Vital-link/Vital-link-hardware/generalDesign_documentation/GenericNodeDesignDecisionDocumentation.docx

# XIAO NRF52840 board or CUSTOM BOARD

| Pros
Xiao | - More reliable as it already works - Very small PCB(hard to beat) - cheaper
Custom pcb | - More learning - Slightly more customizable

Verdict:

By default, we will be using the XIAO board, unless there is a reason that the board needs to be more customizable

In terms of learning, I will be working on my own project which includes a lot of the xiao board anyways on the side to build the skills that I want.

# How is the Generic NODE board going to be connected to the sensor board?

We will have a battery sandwich

Node

Battery – 20mm x 12mm x 5mm

Custom SensorPCB

Link for 5.08 mm female headers. Gives 0.8mm offset. This seems to be the standard which seems to fit perfectly. Hopefully.

https://www.digikey.ca/en/products/filter/rectangular-connectors/headers-receptacles-female-sockets/315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

5.08mm male headers

https://www.digikey.ca/en/products/filter/headers-male-pins/314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

The MALE/FEMALE headers for PPG need to be a bit bigger, to allow component placement.

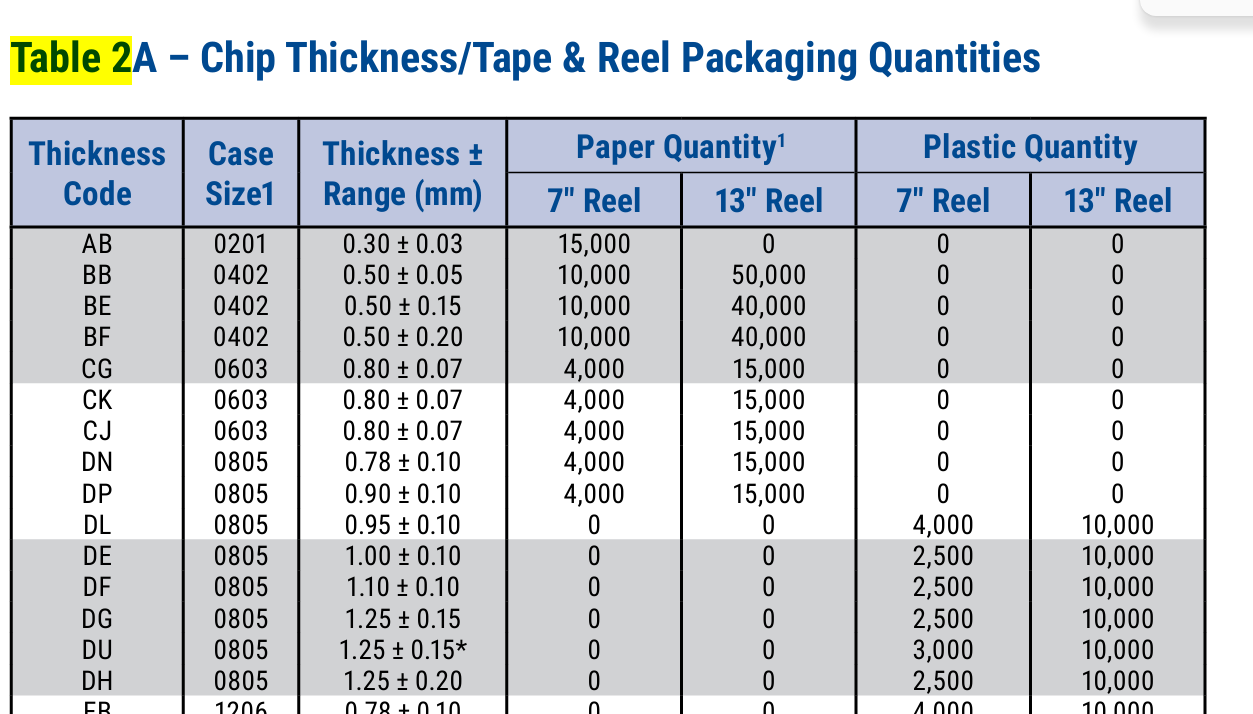
[picture p1: figure]

Figure 1 0805 resistor height

According to the 0805-component sheet. We should allow offset of 1.5mm atleast. We will choose 7mm height headers.

Female - 0.100" (2.54mm) Headers, Receptacles, Female Sockets | Rectangular Connectors | Electronic Components Distributor DigiKey (https://www.digikey.ca/en/products/filter/rectangular-connectors/headers-receptacles-female-sockets/315)

Male - 0.100" (2.54mm) Headers, Male Pins | Rectangular Connectors | Electronic Components Distributor DigiKey (https://www.digikey.ca/en/products/filter/headers-male-pins/314)

Header connections should be GOLD to maximize conductivity.

https://www.seeedstudio.com/Seeed-Studio-XIAO-24Ghz-mmwave-Human-Static-Presence-Module-p-6266.html

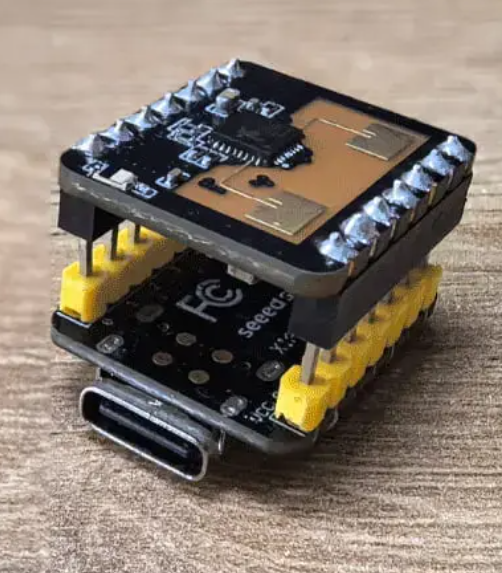
[picture p2: figure]

s
