Vital-link/Vital-link-hardware/generalDesign_documentation/memoryDesign.docx

# MEMORY DESIGNS

# Problem: There is not enough memory to be stored

SD card is chosen because it is the simplest to program and is a universal interface for memory. So, there’s a lot of resources on it.

# Drawbacks:

Significant current surge (100mA) what’s the current usage?

Increases size of product.
