Vital-link/Vital-link-hardware/generalDesign_documentation/EMG RESEARCH.docx

# EMG RESEARCH

## What is EMG signal?

EMG measures the sum of the electrical activity of multiple motor units; these are the motor unit action potentials (MUAPs).[6] This is observed as a bipolar signal with a symmetric distribution of positive and negative amplitudes (mean value equals zero).[7] Raw EMG spikes are of random shape.[7] The observed signal is influenced by the recruitment of the motor units and their firing frequency, as shown in Figure 2.7

The amplitude range of an EMG signal is 0-10 mV (-5 to +5) before amplification.[3] The amplitude has the potential to provide a measure of the magnitude of muscle force, but this relationship is complicated by both the character of the measured EMG and the muscle mechanics.[8] Typically, the frequency of an EMG signal ranges between 6 and 500 Hz, showing the most frequency power between 20 and 250 Hz.[7] An EMG signal is influenced by the firing rate of the motor units, which, in most conditions, fire in the frequency region of 0 to 20 Hz.[3]

# How to pick EMG amplifier?

The function of an amplifier is to take a weak electric signal of the body and increase its amplitude so that it is compatible with recording and displaying devices. A high-quality EMG amplifier has the following characteristics:

- A high input impedance, so as not to distort the signal coming in [6].
- A bandwidth in the frequency band of EMG: between 6 and 500 Hz [1].
- No hardware filters, so the signal information is not altered [1].
- A high common-mode rejection ratio (CMRR). This suppresses all signals ‘common’ to all recorded electrodes. One such example is 50 or 60 Hz powerline noise. Typically, the common mode voltage is much larger than the EMG signal, so a high CMRR is needed to distinguish the EMG signals [1].

# Picked EMG sensor

AD8422 for EMG applications because it has a very high range of changeable gain values. Highest CMRR values that I can find.

AD8236 – HIGH CMRR, input bias current: cutoff at 500Hz

MAX4208 – recommended

Something to consider is that we have high impedance dry electrodes.

And if you are using high impedance electrodes/dry electrodes you need small INPUT BIAS currents (DC current that flows into or out of an amplifier’s input pins so the internal transistors can operate.)

# Dry vs wet electrodes

impedance in the range of 10kΩ. However, when used with an ECG with dry electrodes, the impedance of the dry electrodes is 100 to 1000 times higher than conventional electrodes (for example, 10MΩ for dry electrodes vs. 10kΩ for conventional electrodes).

# Sources

What is the EMG signal - https://www.tmsi.artinis.com/blog/what-is-emghttps://www.tmsi.artinis.com/blog/what-is-emg

Picking AMPLIFIER - https://www.tmsi.artinis.com/blog/recommendations-to-acquire-good-emg-signals

Mains interference - https://www.tmsi.artinis.com/blog/mains-interference

Dry electrodes - https://www.analog.com/en/resources/design-notes/highimpedance-and-lownoise-op-amps-enable-dry-electrodes-in-medical-systems.html
