Vital-link/Vital-link-hardware/meetings/VL_HARDWARE_OVERVIEW_WEEK 3.docx

As of right now my focus will be to focus on ensuring the 3 + 1 sensors work, and concept of a multi-sensor network can be displayed during capstone day. With the sensors being accurate and small.

# TEMPERATURE

# PPG

# ECG

I was thinking about using wet electrode wires with 2mm connectors. However, after doing some more research, I realized how hard it is to get the components. It is more reliable to just build a PCB with 2-3 snap connectors on it with wet electrodes that can be attached onto the body right away.

Backup plan, 3.5mm connectors. With very long wires. You can stick the ECG node into your pocket

# EMG (bonus)

This sensor does not really add much to the narrative of the project. It will be a bonus sensor that is a bit risky but can showcase our technical capability.

I will be using dry electrodes (metal plates) to measure the EMG signals.

# IMU (bonus)

If firmware programmers want more sensors. There is an IMU sensor located within the sense XIAO board that can track step count, etc. This is a useful sensor we could add to our system

# Node

There is discussion about putting an MCU onboard a PCB. For the time being that is not within my plan as it

- provides little value to the project for an extremely high risk (nothing working).
- Takes time away from focusing on parts of project that are critical

One thing we could do that is risk free is once we finish all firmware/hardware is to take the open-sourced PCB and optimize it for our use cases as well as colour coating it + put logo on it.

There is some concern about the battery sandwich design. I should go talk to someone to ensure this is fine for signal integrity. (most likely is fine)

# Battery component choice

Initially I was thinking about using 50mAH which was the perfect size for our node. However, after looking at the shipping time (3 months)

The most reliable design for the node is to increasing battery capacity to 80mAH then adjusting the mechanical design. As 80mAH takes around 1 month to ship (which is much better)

# FLASH MEMORY

After realizing this week that our MCU will not have enough memory to hold raw data for an entire day. Our agreed upon solution is to put additional flash memory onto the sensor/node.

- Users want to be able to not have to carry hub around
- I like this idea as it has opportunity for high-speed digital design. However, is low risk if it doesn’t work as intended

# Potential things to do next week

- Research EMG chips in more detail
- Research affect of battery sandwich battery (return paths, different grounds)
- Begin schematics for ECG/EMG
- Begin flash memory component selection as well as researching a bit on high-speed digital design
