Vital-link/Vital-link-hardware/meetings/VL_HARDWARE_OVERVIEW_WEEK 2.docx

# WEEK 2: OVERVIEW HARDWARE

# What has been done?

## Temperature

- First breakout board ordered

## PPG

- First breakout board ordered

## ECG

- First breakout board has been chosen
- Multiple design options are being evaluated
- Wet electrodes have been chosen, this allows PCB to stick on chest with minimal wires, as well as accuracy to maximize chances of accurate respiratory readings

## EMG

- Picked amplifier with low cmrr and low input bias current making it suitable for EMG usage.
- Determined qualities of an EMG signal such as bandwidth, and amplitude of signals
- Conflict exists between designing an EMG system for unpredictable, low-signal electrode placement and a fixed, repeatable placement optimized for a game-based demo, since each demands different signal-quality assumptions.

# Questions:

## Temperature

Question: Where should these probes ideally be placed to best measure temperature?

Question: How to mount on person to look as nice as possible?

## Questions

## PPG

Question: Do you know how PPT blood pressure works? Explain. Further needs more work

## ECG

Question: Is electrode placement good? Length and positioning.

## EMG

- Using dry electrodes introduces additional noise and stability challenges, requiring more advanced noise-reduction techniques. Which is good for portfolio
- Designing with wet electrodes carries potential real-world
- Decision as of now

As of right now, the decision will be for dry electrodes.
