Vital-link/Vital-link-hardware/generalDesign_documentation/LIPOvsCOINCELL_documentation.docx

# Battery design choice

# Goals (What we want)

- Rechargeable

# Constraints (what MUST OCCUR)

- Over 24 hours of battery life
- Must be comfortable enough to wear for 24 hours
- The enclosure must have an appearance suitable for daily wear.
- Must be light weight enough to be held by electrode pads

# Options Considered

## Battery choice

### Coin Cell (CR2032)

- Easy to design minimal form factor around.
- Highest level of battery capacity
- Low levels of maximum current draw

### Li-Po Pouch Cell

- Rechargeable

So, for the Battery choice, we need to determine if the LIPO can

1. Be designed easily mechanically. Can it fit into the enclosure in a nice way
2. Does it have enough battery life to sustain 24 hours

# 3. Key Trade-offs

A primary trade-off in battery selection is between rechargeability and peak current capability versus simplicity and form factor.

Although the CR2032 coin cell has a higher nominal capacity (~225 mAh) compared to a 100 mAh Li-Po cell, its usable capacity is significantly reduced under pulsed, multi-milliamp loads due to high internal resistance and voltage sag. In practice, only approximately 30–70% of the rated capacity is accessible in BLE-based wearable applications.

In contrast, a 100 mAh Li-Po cell typically provides 85–95% of its rated capacity due to low internal resistance and stable voltage delivery, making its effective usable energy comparable to that of a CR2032 under realistic operating conditions.

The Li-Po solution supports higher peak currents required by BLE radio transmissions and PPG LED pulses but introduces additional charging and safety circuitry, increasing system complexity. The CR2032 offers a simpler and smaller solution but is less suitable for continuous sensing and higher duty-cycle operation.

# 4. Final Decision

Overall, the Li-Po battery is selected due to its ability to reliably supply higher peak currents, which are required for BLE communication and optical sensing, and because the effective usable capacity of a CR2032 coin cell is not significantly greater under realistic operating conditions. A dedicated mechanical structure will be designed around the Li-Po battery to ensure safe integration and protection within the device.

# 5. Risks & Mitigations

With the introduction of a Li-Po battery, there is an inherent risk of thermal runaway if the battery is overcharged. To mitigate this risk, multiple layers of protection will be implemented. These include hardware-level protection through a dedicated charging circuit with overvoltage protection, firmware-level protection by monitoring battery voltage and disabling charging under fault conditions, and mechanical protection by enclosing the battery within a protective chassis to reduce the risk of physical damage
