Vital-link/Vital-link-hardware/generalDesign_documentation/MCU SELECTION.docx

# MCU SELECTION

# ESP32

- Easy to use
- We don’t need WIFI capability
- Extremely energy intensive

# PICO2W

- Easy to use
- Has proprietary antenna. No RF pin. So, it is hard to develop hardware around that as well as is probably does not have good RF capabilities relative to boards that have dedicated pins for RF.

# STM32WB

- We have already developed experience using STM32IDE
- Lack of developed BLE ecosystem

# NRF52840

- Hard skill floor
- NORDIC brands selling point is literally low powered BLE devices. Best for wearables in the industry
- Highly established ecosystem for BLE meaning highest level of control over BLE protocol
- (I intuitively went for this board over STM32)
