Vital-link/Vital-link-hardware/VitalLink_ECG_Breakout_R1/Documentation/ECG_DESIGN.docx

## Why did I choose wet electrodes for ECG?

1. Wet electrodes stick onto the body making node look nicer.
2. On demo day, nobody wants to stick something on their heart that has touched 100 people’s hearts. So, it would just be a visual demo
3. Cleaner signal, reducing concern about extraction of respiration rate.

Something like this would be nice

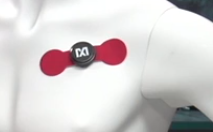
[picture p4: figure]

this is the goal for ECG. WET ELECTRODES. IDC

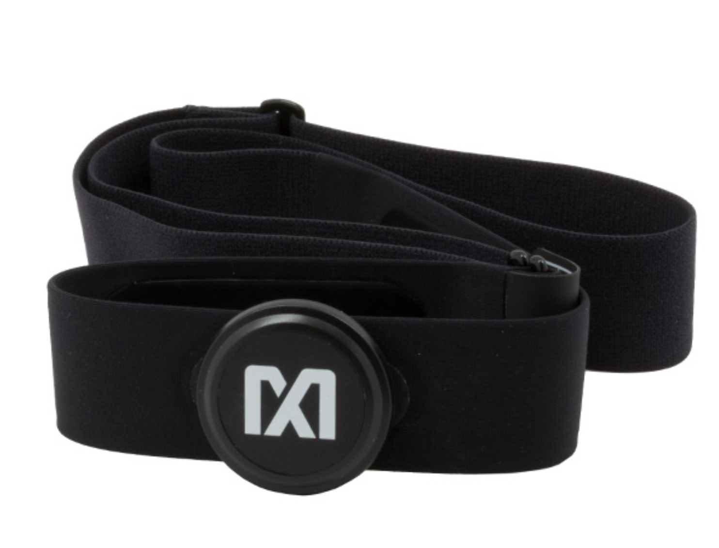
[picture p5: figure]

## Decision:

May be a good idea to talk with Anthony about the ECG/EMG design. Where must the placement of the electrodes be. How far apart must they be.

# Component selection options

MAX30003 – PROVIDES only Heartrate. Simpler but less parameters

MAX30001 – provides heart-rate, bio-impedance, and respiration.

MAX30001 is picked because I’m interested in respiration. It is riskier, but I have a big interest in determining breathe-rate.

MAX30003 can be ordered simultaneously

https://ez.analog.com/temperature_sensors/w/documents/21199/are-there-instructions-to-connect-the-ecg-leads-for-the-max30003-or-max30001

Here it says

Yes, see below. The MAX30001 and MAX30003 use two-lead measurements, with a third lead for body bias (similar to 'right leg drive'). The third lead is optional for battery-powered applications, but should be used if the customer's board is connected to a USB port or power supply.
