Vital-link/Vital-link-hardware/VitalLink_ECG_Breakout_R1/Documentation/ECG-SNAP-UNCERTAINTY.docx

# Problem:

SNAP ECG does not have a clearly defined method of installation on PCB. It has been done, and I am 100% certain it can be done. How it is done, is uncertain

# RESEARCH

## TWO METHODS HAVE BEEN EXPLORED

1. ECG CLAW

Designed specifically for PCB’s however the footprint is harder to make.

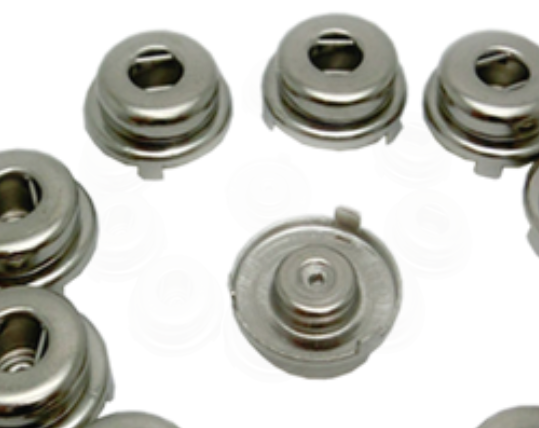
[picture p6: figure]

2. BUMP SNAP ELECTRODES

Easier to make, and μ emg has done it that way. Due to the slanted sides, I’m not certain I want to go with this

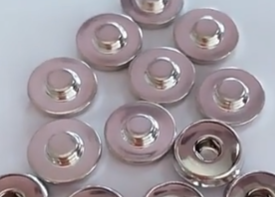
[picture p7: figure]

3. SHORT COLUMN ECG

This one is made for PCB’s but once again there’s a slant

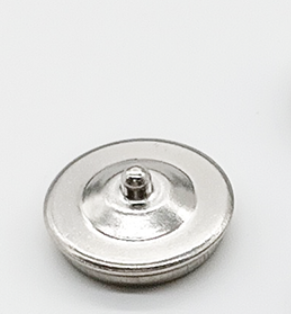
[picture p8: figure]

# Potential implementation

How does a rivot work

So it requires a small hole. Which as of now I have not found

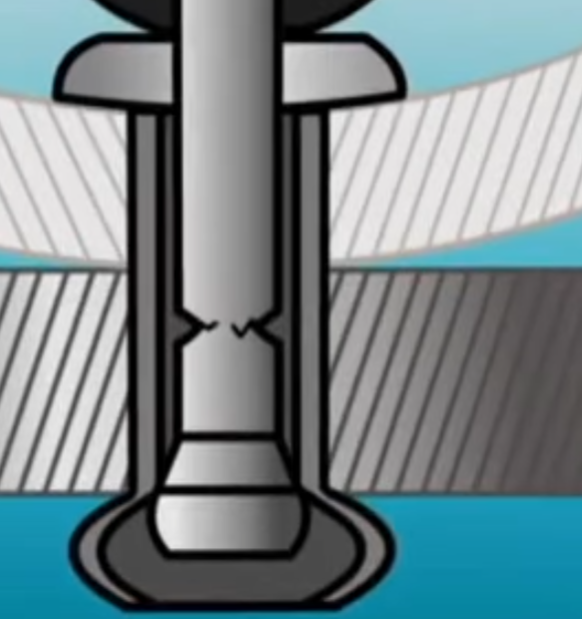
[picture p9: figure]

# Resources

https://www.alibaba.com/product-detail/Nickel-Plating-4-0mm-ECG-Female_1601408208499.html - best documentation with sizes

https://www.alibaba.com/product-detail/4_0mm_Short_Column_ECG_Female_Buckle_with_PCB_Easy_Welding_Terminal_Physiotherapy_Medical_Electronic_Buckle_1601408263267.html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 – this one is “PCB easy”
