Vital-link/Vital-link-hardware/generalDesign_documentation/dataRateCalculations.xlsx

 | EMG | ECG(programmable)
Sampling rate(Hz) | 1100 | 512
Data per sample( bits) | 32 | 32
Data per sample( bytes) | 4 | 4
Datarate (bytes/sec) | 4400 | 2048
Desired use time(H) | 24 | 25
Desired use time(s) | 86400 | 90000
Total data required( MB) | 380.16 | 184.32
