Vital-link/Vital-link-hardware/generalDesign_documentation/powerCalculations.xlsx

V_bat Max(V) | 4.2
V_bat Min(V) | 3.7
LDO V_BAT->3V3 (300mA MAX)
Vdo( Dropout Voltage) | 0.3
