Vital-link/Vital-link-hardware/generalDesign_documentation/Gantt Chart (Excel Template).xlsx

Vital link | Project Start Date | 2025-11-17 |  |  |  | Display Week
 |  |  |  |  |  |  | Week 1 |  |  |  |  |  |  | Week 2 |  |  |  |  |  |  | Week 3 |  |  |  |  |  |  | Week 4 |  |  |  |  |  |  | Week 5 |  |  |  |  |  |  | Week 6 |  |  |  |  |  |  | Week 7 |  |  |  |  |  |  | Week 8
 |  |  |  |  |  |  | 2025-11-17 |  |  |  |  |  |  | 2025-11-24 |  |  |  |  |  |  | 2025-12-01 |  |  |  |  |  |  | 2025-12-08 |  |  |  |  |  |  | 2025-12-15 |  |  |  |  |  |  | 2025-12-22 |  |  |  |  |  |  | 2025-12-29 |  |  |  |  |  |  | 2026-01-05
 |  |  |  |  |  |  | 2025-11-17 | 2025-11-18 | 2025-11-19 | 2025-11-20 | 2025-11-21 | 2025-11-22 | 2025-11-23 | 2025-11-24 | 2025-11-25 | 2025-11-26 | 2025-11-27 | 2025-11-28 | 2025-11-29 | 2025-11-30 | 2025-12-01 | 2025-12-02 | 2025-12-03 | 2025-12-04 | 2025-12-05 | 2025-12-06 | 2025-12-07 | 2025-12-08 | 2025-12-09 | 2025-12-10 | 2025-12-11 | 2025-12-12 | 2025-12-13 | 2025-12-14 | 2025-12-15 | 2025-12-16 | 2025-12-17 | 2025-12-18 | 2025-12-19 | 2025-12-20 | 2025-12-21 | 2025-12-22 | 2025-12-23 | 2025-12-24 | 2025-12-25 | 2025-12-26 | 2025-12-27 | 2025-12-28 | 2025-12-29 | 2025-12-30 | 2025-12-31 | 2026-01-01 | 2026-01-02 | 2026-01-03 | 2026-01-04 | 2026-01-05
WBS | TASK | LEAD | PREDECESSOR | START | END | DAYS | M | T | W | T | F | S | S | M | T | W | T | F | S | S | M | T | W | T | F | S | S | M | T | W | T | F | S | S | M | T | W | T | F | S | S | M | T | W | T | F | S | S | M | T | W | T | F | S | S | M
1 | Networking tasks | Akash | Ryan
1.1 | BLE course |  |  | 2025-11-17 | 2025-12-08 | 22
1.2 | Test 1 Basic functionality - send 1KHz sin wave to hub
1.2.1 | Initiate basic connection to node |  |  | 2025-12-15 | 2025-12-25 | 11
1.2.2 | Rx data continuously |  |  | 2025-12-25 | 2026-01-04 | 11
1.3 | Test 2: Advanced functionality
1.3.1 | Real time Rx from 3+ nodes, with continuous graphs on all 3-10 nodes |  |  | 2026-01-05 | 2026-01-18 | 14
1.3.2 | Design and implement Adjust settings/behaviour on nodes |  |  | 2026-01-05 | 2026-01-25 | 21
1.3.2.1 | add/remove nodes |  |  | 2026-01-05 | 2026-01-12 | 8
1.3.2.2 | change samplingRates |  |  | 2026-01-12 | 2026-01-19 | 8
1.3.2.3 | ect behaviours depending on sensors |  |  | 2026-01-19 | 2026-01-26 | 8
1.4 | Test 3: Data Export
1.4.1 | Have the ability to upload data throughout the day on a set of sensors. |  |  | 2026-02-03 | 2026-02-23 | 21
2 | HUB/GUI ( turn data into actionable feedback) | Akash | Ryan
2.1 | Research and talk people in industry to better understand how our product can best help them help patients. |  |  | 2025-11-17 | 2025-12-01 | 15
2.2 | Derived Metrics Dashboard: Real-time visualization of "3-5" sensors (bobs request) |  |  | 2026-01-05 | 2026-01-11 | 7
2.3 | Node Management Interface
2.3.1 | Enable, disable, connect, disconnect, battery life |  |  | 2025-12-15 | 2026-01-05 | 22
2.3.2 | Options to change behaviour of sensors. sampling rate, filtering, additional behaviour of sensors, alert thresh-holds |  |  | 2025-12-15 | 2026-01-05 | 22
2.4 | Upload mode
2.4.1 | upload data from sensors onto hub |  |  | 2025-12-15 | 2026-01-05 | 22
2.5 | Derive usable metrics
2.5.1 | Derive heart-rate from PPG signals |  |  | 2026-02-13 | 2026-02-26 | 14
2.5.2 | Derive heart-rate from ECG signals |  |  | 2026-02-26 | 2026-03-11 | 14
2.5.3 | Calculate respiratory rate from ECG |  |  | 2026-02-26 | 2026-03-11 | 14
2.5.4 | Estimate blood pressure from ECG+PPG timing (trend-based). |  |  | 2026-02-26 | 2026-03-11 | 14
3 | Node firmware/sensors | Parry | Akash
3.1 |  |  |  | 2022-11-17 | 2022-11-17 | 1
3.2 | Nordic SDK COURSE |  |  | 2025-11-17 | 2025-12-08 | 22
3.3 | Accept basic connection |  |  | 2025-12-15 | 2026-01-05 | 22
3.4 | Tx data continously |  |  | 2025-12-15 | 2026-01-05 | 22
3.5 | Tx data with proper ID system |  |  | 2026-01-05 | 2026-01-18 | 14
3.6 | Code temperature sensor |  |  | 2026-01-18 | 2026-01-31 | 14
3.7 | Code PPG sensor |  |  | 2026-01-31 | 2026-02-13 | 14
3.8 | Code ECG sensor |  |  | 2026-02-13 | 2026-02-26 | 14
4 | Mechanical design( ensure signals can be properly measured) | Jishiv | Ryan
4.1 | Design and think about Ideal form-factors for sensors |  |  | 2025-11-17 | 2025-12-16 | 30
4.2 | Temperature(Side of the Chest (High accuracy for medical-grade)) |  |  | 2026-01-18 | 2026-01-31 | 14
4.3 | PPG(underside of wrist) |  |  | 2026-01-31 | 2026-02-13 | 14
4.4 | ECG(chest) - with 3 electrodes |  |  | 2026-02-13 | 2026-02-26 | 14
5 | Hardware tasks | Parry | Jishiv
5.1 | Node PCB |  |  | 2025-11-17 | 2026-02-14 | 90
5.2 | Temperature sensor PCB |  |  | 2026-01-31 | 2026-02-13 | 14
5.3 | PPG sensor PCB |  |  | 2026-02-13 | 2026-02-26 | 14
5.4 | 1 Lead ECG PCB |  |  | 2026-02-26 | 2026-03-11 | 14
6 | Testing | Akash | everyone
6.1 | Test sensors |  |  | 2026-03-16 | 2026-03-29 | 14
6.1.1 | Compare ECG, Respiratory rate, and Temperature with reference to medical grade equipment |  |  | 2026-03-17 | 2026-03-30 | 14
6.1.2 | Test vital signs in varying conditions such as movement, and varying external environments |  |  | 2026-03-18 | 2026-03-31 | 14
6.1.3 | Collect data spanning several days and interpolating results from it |  |  | 2026-03-19 | 2026-04-01 | 14
7 | Documentation, and Presentation | Ryan | everyone
7.1 | Poster |  |  | 2026-03-16 | 2026-04-14 | 30
7.2 | Practice presentation |  |  | 2026-04-14 | 2026-04-28 | 15
7.3 | Final documentation of project |  |  | 2026-03-16 | 2026-04-29 | 45
TEMPLATE ROWS
See the Help worksheet to learn how to use these rows. You can hide these rows before printing.
1 | [ Level 1 Task or Phase ] |  |  |  | -
1.1 | . [ Level 2 Task ] |  |  |  | -
1.1.1 | . . [ Level 3 Task ] |  |  |  | -
1.1.2 | . . [ Level 3 Task ] |  |  |  | -
1.1.2.1 | . . . [ Level 4 Task ]
► Watch How to Create a Gantt Chart in Excel (https://vertex42.link/HowToCreateAGanttChart)
 |  |  |  |  |  |  |  |  |  |  |  |  |  |  |  |  |  |  |  |  |  |  |  |  |  |  |  |  |  |  | d
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
