Vital-link/Vital-link-hardware/generalDesign_documentation/projectPlanningVital-linkHDWR.xlsx

Sheet: FMEA
Item | Function | Failure Mode | Failure Effect | Severity | Cause | Occurrence | Current Controls | Detection | RPN | Recommended Action
Battery management | Charge LIPO safely | overcharge( cell voltage above 4.2V) | Heating and fire | 10 |  | 2 | Component protects against it | 3 | 60 | overvoltage protection. Firmware to protect Mechanical chasis around battery

Sheet: Component considerations
nPM1100 | BMS with charging, Thermal protection | https://octopart.com/search?q=nPM1100&currency=USD&specs=0
2mm connector male pads |  | https://www.amazon.ca/-/fr/TENS-%C3%A9lectrodes-autocollantes-r%C3%A9utilisables-connecteur/dp/B01F7AC0Z0
4mm ECG female pads |  | https://www.alibaba.com/product-detail/Medical-ECG-Electrode-Super-Quality-4_1600619525286.html

Sheet: power calculations
 | Goals & Constraints
 | CRC2032 Battery | Lipo pouch
Battery capacity( m Ah) | 225 | 100
Minimum operating time(h) | 24 | 24
ideal maximum current(mA) | 9.375 | 4.166666667
 | PPG( Maxrefdes117)
Current usage | 1.5
