Vital-link/Vital-link-hardware/BOM/Vital-Link-BOM3-V1.xlsx

BOM #: | 3
Group: | Multi-Sensor Health Monitoring System
Names: | Zhuo, Parry
 | Purohit, Jishiv
 | Brar, Akashdeep
 | Inguito, Ryan
Mentor: | Bob Gill
Address: | BCIT SW1-3069
# | Link | Manufacturer Part Number | Description | Quantity | Shipping Price | Unit Price | Cost | Notes
1 | https://www.amazon.ca/EEMB-402535-Rechargeable-Connector-Certified/dp/B08215N9R8?s=electronics |  | EEMB 3.7V 320mAh 402535 Rechargeable Lithium Polymer ion Battery Pack with JST Connector UN38.3 Certified | 3 | $0.00 | $24.59 |  | Ordering extra batteries incase batteries do not come before Apr 13th
2 | https://www.mouser.ca/ProductDetail/Seeed-Studio/102010631?qs=sGAEpiMZZMu3sxpa5v1qrsYBRKJKqD9T9JlltKkqJJ8%3D | 102010631 | Multiprotocol Development Tools Seeed Studio XIAO nRF52840 (Pre-Soldered) | 3 | $0.00 | $16.39 |  | Extra XIAO boards for additional sensors
 |  |  |  | SUBTOTAL | $0.00
 |  |  |  | TAX (12%) | $0.00
 |  |  |  | TOTAL | $0.00
