Vital-link/Vital-link-hardware/BOM/Vital-Link-BOM2-V3.xlsx

BOM #: | 2
Group: | Multi-Sensor Health Monitoring System
Names: | Zhuo, Parry
 | Purohit, Jishiv
 | Brar, Akashdeep
 | Inguito, Ryan
Mentor: | Bob Gill
Address: | BCIT SW1-3069
# | Link | Manufacturer Part Number | Description | Quantity | Shipping Price | Unit Price | Cost | Notes
1 | https://www.mouser.ca/ProductDetail/Analog-Devices-Maxim-Integrated/MAX30003WING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 | MAX30003WING# | Data Conversion IC Development Tools ECG AFE feather board | 1 | $0.00 | $64.81 | $64.81 | ECG specific board
2 | https://www.mouser.ca/ProductDetail/SparkFun/SEN-12969?qs=WyAARYrbSnaajKSHkjOGnw%3D%3D | SEN-12969 | Biometric Sensors Disposable Surface EMG/ECG/EKG Electrode - 24mm (10 pack) | 2 | $0.00 | $14.83 | $29.66 | 3 x 10pack for 0$ shipping
3 | https://www.aliexpress.com/item/1005009180943063.html?curPageLogUid=4L9aGEGiNkMr | 80mAh Lithium battery | 1Piece 3.7V 80mAh 501220 Rechargeable Lithium Battery For Headsets 3D Glasses Sports Bracelets More Gadgets | 5 | $5.34 | $4.79 | $27.37 | 8% off on 10 items. 80mAH Battery, expected delivery time is 1 month
4 | https://www.digikey.ca/en/products/detail/adafruit-industries-llc/5769/21839817?gclsrc=aw.ds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 | 5769 | ADAFRUIT AUDIO BFF ADD-ON FOR QT | 1 | $0.00 | $8.59 | $8.59
5 | https://www.amazon.ca/Buttons-Clothes-Fastener-Clothing-Handbag/dp/B0DBR3X78N |  | Sew on Snap Buttons, 20 Sets Clothes Hidden Sew on Press Studs Button Metal Snaps Fastener for Sewing Clothing Craft Handbag 12mm 8.5mm | 1 | $0.00 | $7.97 | $7.97
6 | https://udevices.io/products/disposable-gel-electrodes | UD-0009 | Disposable gel electrodes (30mm, 10pcs pack) | 4 | 11.6 | 6.83 | $27.32
 |  |  |  | SUBTOTAL | $165.72
 |  |  |  | TAX (12%) | $19.89
 |  |  |  | TOTAL | $185.61
