Vital-link/Vital-link-hardware/BOM/Vital-Link-BOM1-V5.xlsx

BOM #: | 1
Group: | Multi-Sensor Health Monitoring System
Names: | Zhuo, Parry
 | Purohit, Jishiv
 | Brar, Akashdeep
 | Inguito, Ryan
Mentor: | Bob Gill
Address: | BCIT SW1-3069
# | Link | Manufacturer Part Number | Description | Quantity | Shipping Price | Unit Price | Cost | Notes
1 | https://www.mouser.ca/ProductDetail/Seeed-Studio/102010448 | Seeed Technology Co., Ltd | XIAO NRF52840 | 3 | $0.00 | $15.83 | $47.49 | Nordic Microcontroller. Used as node
3 | https://www.mouser.ca/ProductDetail/DFRobot/SEN0344?qs=eP2BKZSCXI5r1K2DgtfmoA%3D%3D&mgh=1 | Multiple Function Sensor Development Tools Fermion: MAX30102 PPG Heart Rate and Oximeter Sensor (Breakout, I2C/UART) | Multiple Function Sensor Development Tools Fermion: MAX30102 PPG Heart Rate and Oximeter Sensor (Breakout, I2C/UART) | 1 | $0.00 | $24.65 | $24.65 | PPG
4 | https://www.mouser.com/ProductDetail/Mikroe/MIKROE-2554?qs=%252BdQmOuGyFcEzIy4bOMOUkw%3D%3D | 1471-1754-ND | MAX30205 Temperature Sensor mikroBUS™ Click™ Platform Evaluation Expansion Board | 1 | $0.00 | 20.15 | $20.15 | Temperature
5 | https://www.mouser.ca/ProductDetail/SparkFun/CAB-12970?qs=WyAARYrbSnarMCPDsw5WDQ%3D%3D | 12970 | SENSOR CABLE - ELECTRODE PADS (3 | 1 | $0.00 | $14.88 | $14.88
 |  |  |  | SUBTOTAL | $107.17
 |  |  |  | TAX (12%) | $12.86
 |  |  |  | TOTAL | $120.03
