Vital-link/Vital-link-hardware/VitalLink_ECG_Breakout_R1/imports/35RASMT2BHNTRX/35RASMT2BHNTRX.STEP

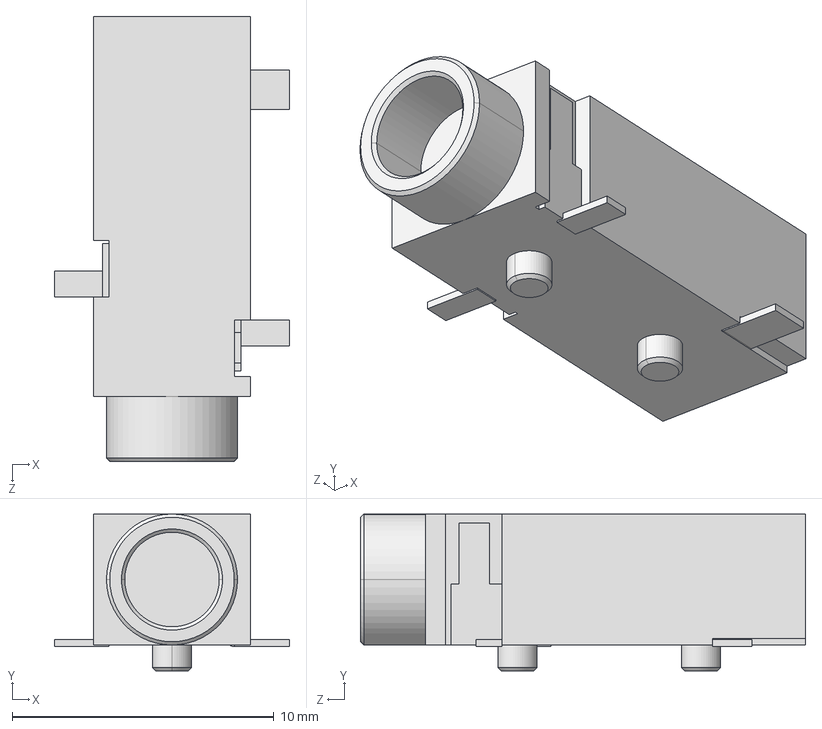
[picture p10: CAD file, 2026-02-27]
VitalLink_ECG_Breakout_R1/imports/35RASMT2BHNTRX/35RASMT2BHNTRX.STEP
8.99 x 5.99 x 17.0 mm
