Vital-link/Vital-link-hardware/imports/MAX1726EUK18_T/MAX1726EUK18_T.step

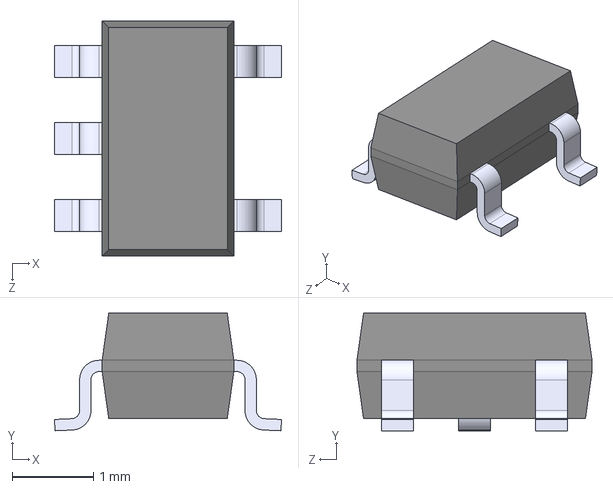
[picture p11: CAD file, 2026-03-09]
imports/MAX1726EUK18_T/MAX1726EUK18_T.step
2.80 x 1.45 x 2.90 mm
