Vital-link/Vital-link-hardware/imports/CONN MICRO SD CARD RA SMD/472192001.stp

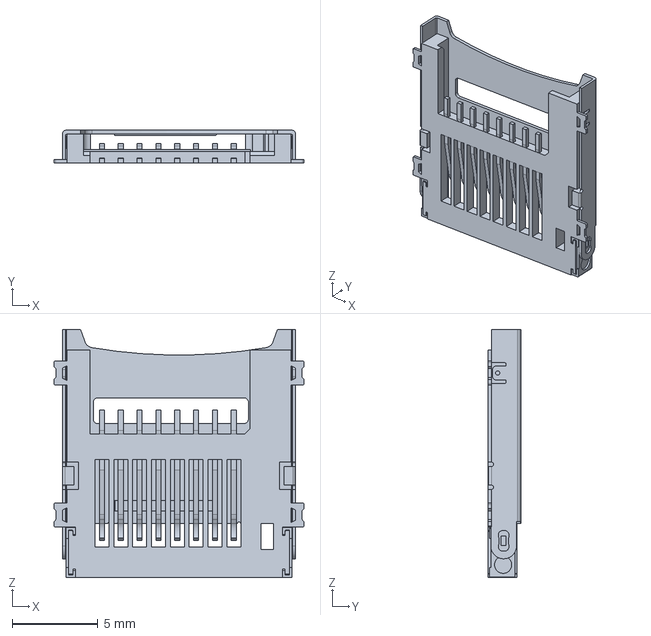
[picture p12: CAD file, 2026-03-09]
imports/CONN MICRO SD CARD RA SMD/472192001.stp
14.6 x 1.90 x 14.5 mm
