Vital-link/Vital-link-hardware/imports/MAX30003CTI_/MAX30003CTI+.STEP

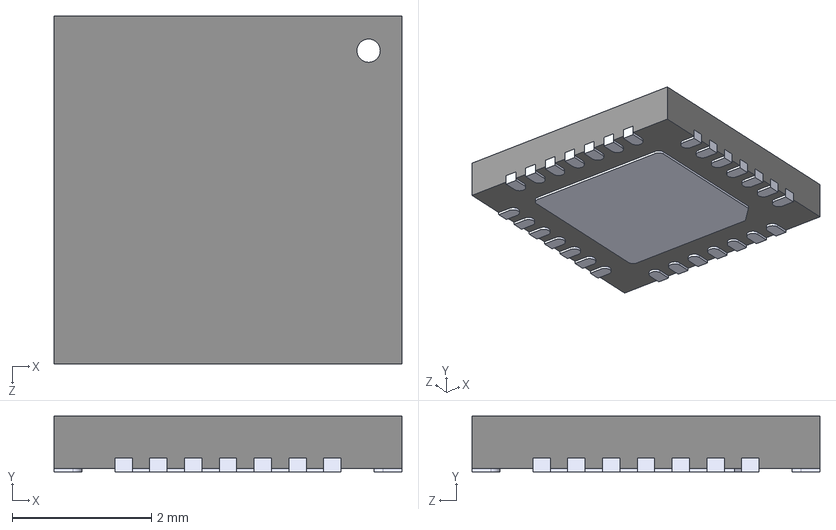
[picture p13: CAD file, 2026-03-09]
imports/MAX30003CTI_/MAX30003CTI+.STEP
5.00 x 0.8 x 5.00 mm
