Vital-link/Vital-link-hardware/VitalLink_ECG_Breakout_R1/imports/102010448.STEP

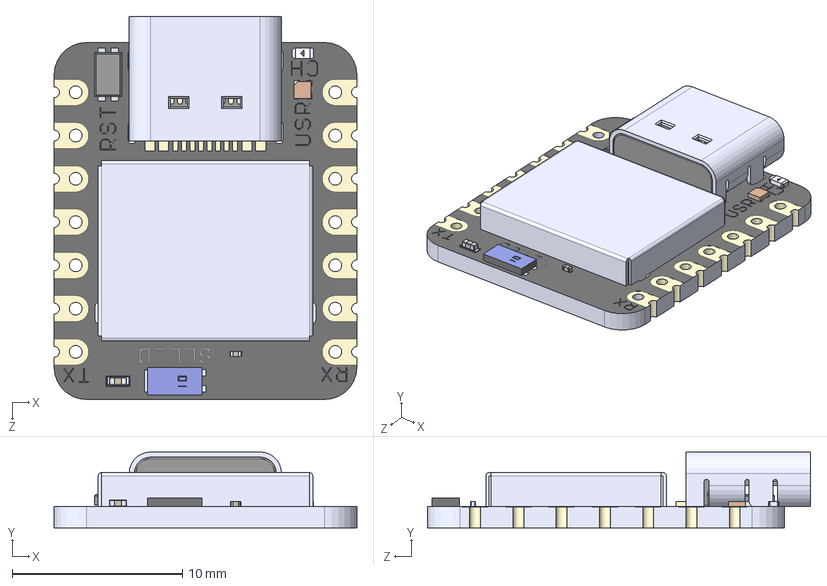
[picture p14: CAD file, 2026-01-19]
VitalLink_ECG_Breakout_R1/imports/102010448.STEP
17.8 x 4.46 x 22.5 mm
