Vital-link/Vital-link-hardware/simulations/SSD_LOAD_SWITCH.asc

C1: cap; 10µ
C2: cap; 1µ
C3: cap; 0.1µ
I1: current; PULSE(0.001 0.1 0.1 5u 5u 2m 1)
R1: res; 330
R2: res; 10K
R3: res; 10K
U1: FDN340P
V1: voltage; 3.3
V2: voltage; PULSE(3.3 0 10m 1u 1u 100 1)
Named nets: 0
.lib C:\\Users\\Parry\\Documents\\GITHUB_desktop\\Vital-link-hardware\\simulations\\library\\FDN340P.lib
Assume burst is 100ma, for 2ms
.tran 5
