Vital-link/Vital-link-hardware/(list of files, drawings)

Other design files:
imports/ASEK-32.768KHZ-L-R-T/ASEK-32.768KHZ-L-R-T/ASEK-32.768KHZ-L-R-T.SchLib
imports/ASEK-32.768KHZ-L-R-T/ASEK-32.768KHZ-L-R-T/XTAL_ASEK-32.768KHZ-L-R-T.PcbLib
imports/CONN MICRO SD CARD RA SMD/472192001/472192001.PcbLib
imports/CONN MICRO SD CARD RA SMD/472192001/472192001.SchLib
VitalLink_ECG_Breakout_R1/imports/AltiumDesigner-Libraries-main/VitalLink.SchLib
VitalLink_ECG_Breakout_R1/imports/Imported MCU_SEEED_XIAO_Series/MCU_SEEED_XIAO_Series.PrjPcb
VitalLink_ECG_Breakout_R1/imports/Imported MCU_SEEED_XIAO_Series/MCU_SEEED_XIAO_Series.SchLib
