Vital-link/Vital-link-hardware/VitalLink_ECG_Breakout_R1/Documentation/ECG ROUTING RISKS.docx

# ECG ROUTING RISKS

# The SSD card pulls 100mA over 2ms.

What effect does this have on the LDO? Will there be enough power??

Do I really need the bypass caps near the MOSFET?

Do I really need the mosfet?

# Routing ANALOG signal next to power trace.

Due to PCB restrictions, it seems I’m going to have to route a sensitive analog signal next to the 3V3 power trace. So this is risky.

Answering a question above there, we will want to put caps near our components to reduce the high frequency components in the power trace.
