Vital-link/Vital-link-hardware/(commit log)

2025-12-06 EXCEL sheet updated to account for EMG somewhat
    [vital-linkGantchart-V1.xlsx]
2025-12-13 bom added
    [Vital-Link-BOM1-V4.xlsx]
2025-12-16 beginning documentation of nodes,ect - lipo vs coincell battery - MCU selection reasoning - node design( not finished) - project planning excel sheet
    [projectPlanningVital-linkHDWR.xlsx, vital-linkGantchart-V1.xlsx]
2025-12-18 documented decision on why I am using XIAO boards as generic node.
2025-12-29 research done on ECG/EMG sensors (nothing is finalized) - connectors picked: 2mm - research done on ECG/EMG( not finished)
2026-01-16 (documentation) reason for picking dry/wet electrodes for EMG/ECG respectively
    [ComponentSelection_ECG_VL_R1.xlsx, Gantt Chart (Excel Template).xlsx, Gantt Chart_VL.xlsx, Vital-Link-BOM1-V4.xlsx, Vital-Link-BOM1-V5.xlsx, Vital-Link-BOM2-V1.xlsx, projectPlanningVital-linkHDWR.xlsx]
2026-01-19 (Schematic) imported generic library alongside XIAO_NRF board
    [102010448.STEP, MCU_SEEED_XIAO_Series.PrjPcb, MCU_SEEED_XIAO_Series.SchLib, VitalLink.SchLib]
2026-01-26 (Component selection and documentation) bomV2 and hardware overview
    [Vital-Link-BOM2-V1.xlsx, VitalLink.SchLib, powerCalculations.xlsx]
2026-02-27 bom 3 created
    [35RASMT2BHNTRX.STEP, Vital-Link-BOM2-V1 - Copy (2).xlsx, Vital-Link-BOM2-V1 - Copy (3).xlsx, Vital-Link-BOM2-V1 - Copy (4).xlsx, Vital-Link-BOM2-V1 - Copy.xlsx, Vital-Link-BOM3-V1.xlsx, powerCalculations.xlsx]
2026-03-09 added ECG routing risks document
    [472192001.PcbLib, 472192001.SchLib, 472192001.stp, ASEK-32.768KHZ-L-R-T.SchLib, ECG_draftBOM.xlsx, MAX1726EUK18_T.step, MAX30003CTI+.STEP, Vital-Link-BOM2-V2.xlsx]
2026-03-11 Made sure boms are accurate
    [Vital-Link-BOM2-V3.xlsx, Vital-Link-BOM3-V1.xlsx]
2026-03-12 added documentation on connectors used. To fit battery, iin battery sandwhich design as well as potential components on the back-side of the board
    [Vital-Link-BOM2-V3.xlsx]
2026-03-17 ECG MFT files added with BOM,GERBERS,CPL
2026-03-17 PPG MFT files finished
    [VL_PPGSensor_R1-BOM.csv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]
2026-03-17 added VL_TEMP_BREAKOUT_R1
    [VL_Temp_Breakout_R1-BOM.csv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]
2026-03-18 ensure commit was made
    [VL_ECG_R1-BOM.csv, Vital-Link-BOM3-V1.xlsx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]
2026-03-29 Initialize README with project details and images
    Added project overview and sensor categories with images.
